realsolarcarsllc/solarcarengineering/README.md

# Solar Car Engineering Support Package

This is a combined repository for most RSC boards.

We are packaging everything together for easier downloads. 
Look for the green "code" menu above. 
Open it and select the "Download Zip" option.

# Engineering Info
- Contactors and Battery Connections (SCE 01)
- Charging EVs from Supercapacitors (they don't hold enough energy)

# Boards
- pcdb2105 - 36v to 400v dc-dc converter with MPPT, aux buck converter, contactor control, coil economizer, dual CAN, failsafe CAN bridge, real time clock
- bci2103 - 40 pin connector to wire interface, with holes for pass-through diodes

© 2022 Real Solar Cars, LLC  
PO Box 9372   
Albuquerque, NM 87119-9372  
USA
