realsolarcarsllc/solarcarengineering/boards/README.md

# pcdb2105
High voltage DC-DC slow charger
- Input 31-45 Vdc MPPT, intended for 72 cell solar array
- Main Output 300-405 Vdc, >300w , isolated
- Aux Output 13.8 Vdc 5A nominal, programmable 0-30 Vdc, step down
- 40 pin connector for 12v GPIO
- - 5 Contactor control outputs with -36v coil suppression. 
- - - 3 with 0-5 Vdc economizer
- - 2 12v 1a max general purpose outputs with pass-through diode
- - 3 12v 1a max general purpose outputs
- - 2 CAN bus interfaces, with optional failsafe pass-through
- - 7 12v analog input pins
- 4 pin fan connector
- - 2 12v 1a max general purpose outputs
- qwiic connector
- Optional DS1307 real time clock

# bci2103
40 pin IO breakout board
- 7 passthrough diodes for contactor and control signals
- pads for EEPROM (not used)
