realsolarcarsllc/solarcarengineering/engineering/supercapacitor-charging-test.ods

Event | Timestamp | Volts
connected | 00:28
contactors | 00:31
 | 00:35 | 14.2
honk | 00:40 | 14.06
 | 00:45 | 13.7
 | 00:50 | 13.44
 | 00:55 | 13.13
 | 01:00 | 12.82
 | 01:05 | 12.51
 | 01:10 | 12.17
 | 01:15 | 11.82
 | 01:20 | 11.49
depleted | 01:27 | 10.97 | 00:00:47
 | 01:30 | 11.1
 | 01:40 | 11.3
 | 01:50 | 11.49
 | 02:00 | 11.68
 | 02:10
 | 02:20 | 12.04
 | 02:30 | 12.23
 | 02:40 | 12.4
 | 02:50
 | 03:00
 | 03:10
 | 03:20 | 13.05
 | 03:30 | 13.19
 | 03:40 | 13.3
 | 03:50 | 13.4
 | 04:00 | 13.5
 | 04:10 | 13.59
 | 04:20 | 13.68
 | 04:30
 | 04:40 | 13.82
 | 04:50
 | 05:00 | 13.93
 | 05:10 | 13.98
connected | 05:15 | 14
contactors | 05:17 | 14.01
 | 05:20 | 14.02
honk | 05:28 | 13.9 | 00:04:01
 | 05:30 | 13.81
 | 05:35 | 13.5
 | 05:40 | 13.2
 | 05:45 | 12.88
 | 05:50 | 12.59
 | 05:55 | 12.24
 | 06:00 | 11.89
 | 06:05 | 11.5
 | 06:10 | 11.17
 | 06:15 | 10.77
end | 06:20 | 10.46 | 00:00:52
 | Seconds
Discharge 1 | 47
Recharge | 241 | 173 | if losses fixed
Discharge 2 | 52
Cycle Time | 293
Minutes/Cycle | 4
Cycles/Hour | 15
Hours/Day | 8
Cycles/Day | 120
Cycles/Year | 43800
 |  | Years
Mechanical | 200000 | 4.57
Full Load | 3000 | 0.07
Per Capacitor | $57.00
6s Pack | $342.00
Per Cell | $61.67
6s Pack | $370.00
Volts | 2.3
Ah | 35
Cells | 6
Wh | 483
80% Discharge | 386 | Wh
Volts | 120
Watts | 6.5
AC Power | 780
Inverter | 90.00%
DC Power | 867
 |  | Hours
PV Charge W | 300 | 1.29
Discharge W | 567 | 0.68
 |  | 1.97
Minutes/Cycle | 118.19
Cycles/Hour | 0.51
Hours/Day | 8.00
Cycles/Day | 4.06
Cycles/Year | 1482
 |  | Years
Mechanical | 200000 | 134.92
Full Load | 3000 | 2.02
Battery Cycles | 20000 | 13.49
Conclusions
Supercapacitors should not be used for solar charging EVS.
 | Does not store enough energy
 | EV contactors will wear out
Lithium Titanate batteries appear to be suitable for this purpose.
 | Acceptable 4 cycles/day on EV contactors
 | Expected to last 13 years
 | Cost similar to supercapacitors
