realsolarcarsllc/solarcarengineering/boards/bci2103/schematic.pdf

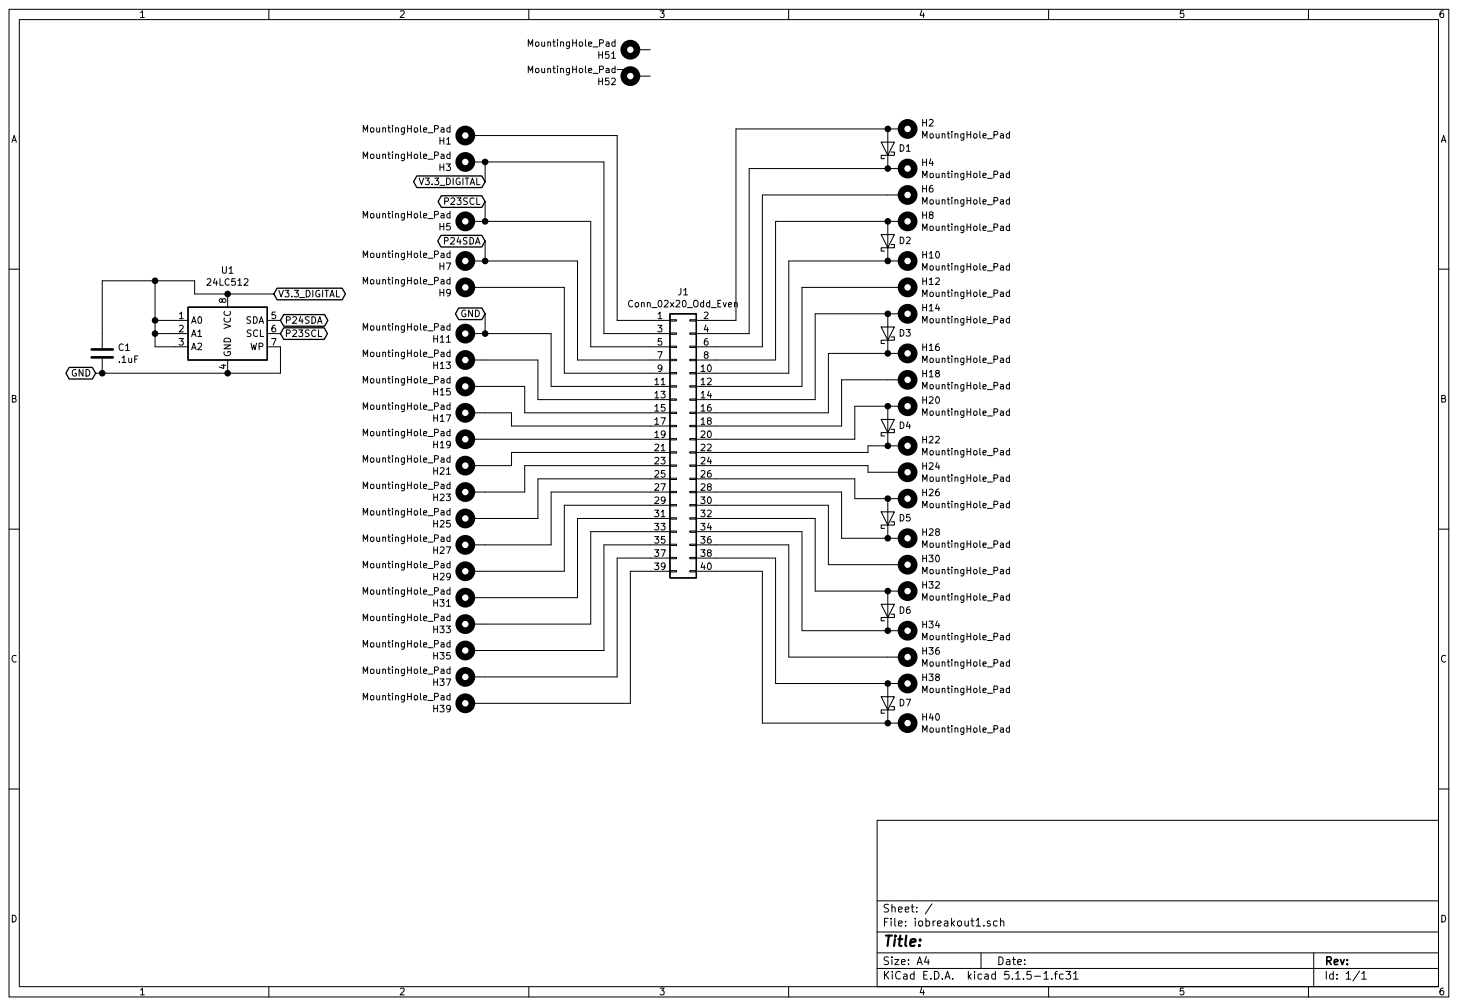
[picture p1: page 1]

31 | 32
33 | 34
35 | 36
37 | 38

Id: 1/1 Title: File: iobreakout1.sch Sheet: /
