realsolarcarsllc/solarcarengineering/boards/bci2103/iobreakout1.kicad_pcb

## KiCad design boards/bci2103/iobreakout1.kicad_pcb (2021-10-12)

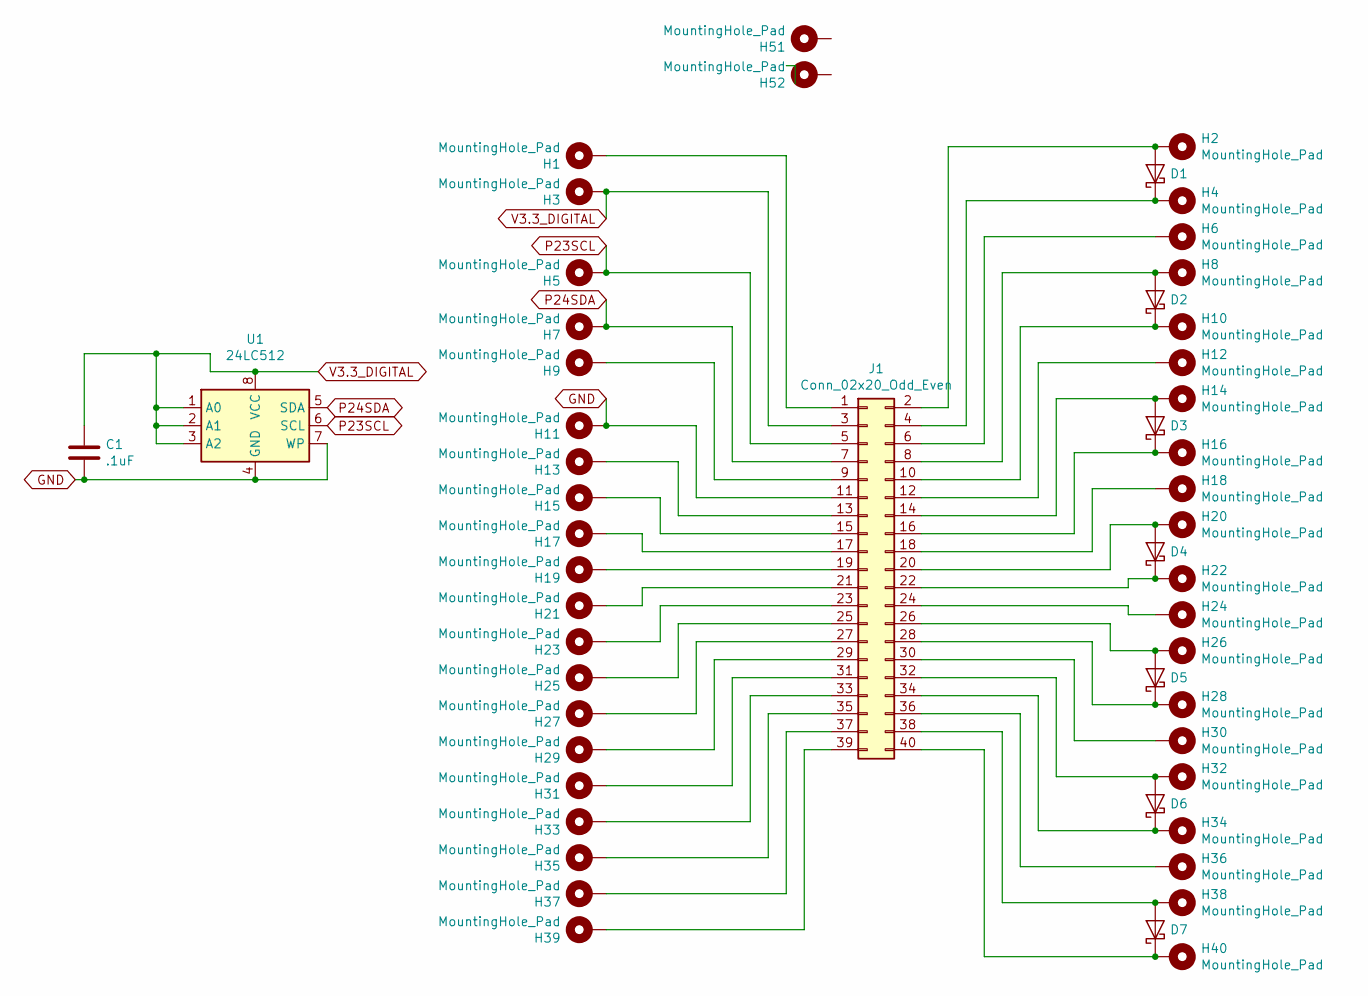
[picture p13: schematic iobreakout1.sch]

Parts:
C101: .1uF; C_0603_1608Metric_Pad1.05x0.95mm_HandSolder
D1, D2, D3, D4, D5, D6, D7: 1N5819; D_DO-41_SOD81_P2.54mm_Vertical_AnodeUp
H1, H2, H3, H4, H5, H6, H7, H8, H9, H10, H11, H12, H13, H14, H15, H16, H17, H18, H19, H20, H21, H22, H23, H24, H25, H26, H27, H28, H29, H30, H31, H32, H33, H34, H35, H36, H37, H38, H39, H40: MountingHole_Pad; TestPoint_THTPad_D2.5mm_Drill1.2mm
H51, H52: MountingHole_Pad; MountingHole_3mm_Pad_Via
J1: Conn_02x20_Odd_Even; PinSocket_2x20_P2.54mm_Vertical
U1: 24LC512; TSSOP-8_4.4x3mm_P0.65mm

Connections:
GND: H11.1, J1.11, U1.4 (GND), U1.7 (WP); also elsewhere on the board
unnamed: D1.1 (K), H4.1, J1.4
unnamed: D1.2 (A), H2.1, J1.2
unnamed: D2.1 (K), H10.1, J1.10
unnamed: D2.2 (A), H8.1, J1.8
unnamed: D3.1 (K), H16.1, J1.16
unnamed: D3.2 (A), H14.1, J1.14
unnamed: D4.1 (K), H22.1, J1.22
unnamed: D4.2 (A), H20.1, J1.20
unnamed: D5.1 (K), H28.1, J1.28
unnamed: D5.2 (A), H26.1, J1.26
unnamed: D6.1 (K), H34.1, J1.34
unnamed: D6.2 (A), H32.1, J1.32
unnamed: D7.1 (K), H40.1, J1.40
unnamed: D7.2 (A), H38.1, J1.38
unnamed: H1.1, J1.1
unnamed: H6.1, J1.6
unnamed: H9.1, J1.9
unnamed: H12.1, J1.12
unnamed: H13.1, J1.13
unnamed: H15.1, J1.15
unnamed: H17.1, J1.17
unnamed: H18.1, J1.18
unnamed: H19.1, J1.19
unnamed: H21.1, J1.21
unnamed: H23.1, J1.23
unnamed: H24.1, J1.24
unnamed: H25.1, J1.25
unnamed: H27.1, J1.27
unnamed: H29.1, J1.29
unnamed: H30.1, J1.30
unnamed: H31.1, J1.31
unnamed: H33.1, J1.33
unnamed: H35.1, J1.35
unnamed: H36.1, J1.36
unnamed: H37.1, J1.37
unnamed: H39.1, J1.39
P23SCL: H5.1, J1.5, U1.6 (SCL)
P24SDA: H7.1, J1.7, U1.5 (SDA)
V3.3_DIGITAL: H3.1, J1.3, U1.1 (A0), U1.2 (A1), U1.3 (A2), U1.8 (VCC); also elsewhere on the board

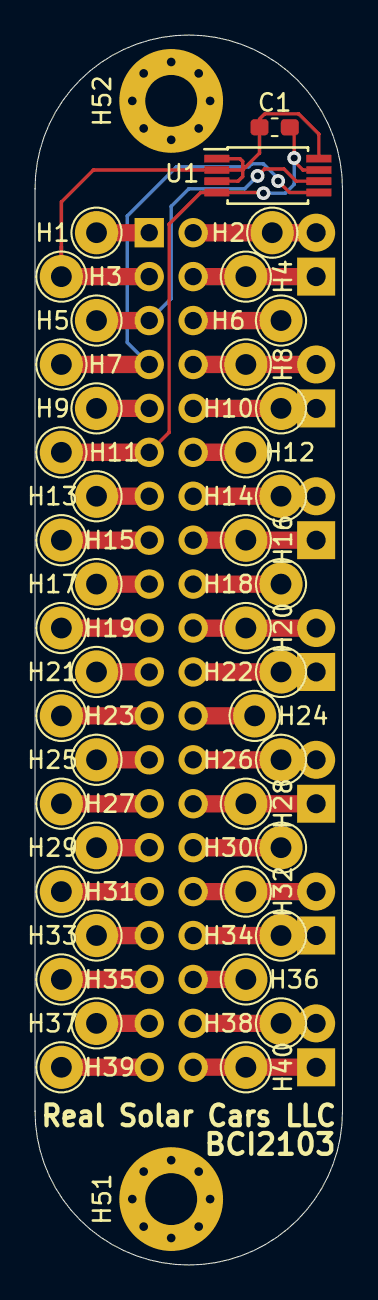
[picture p14: board iobreakout1.kicad_pcb from above]

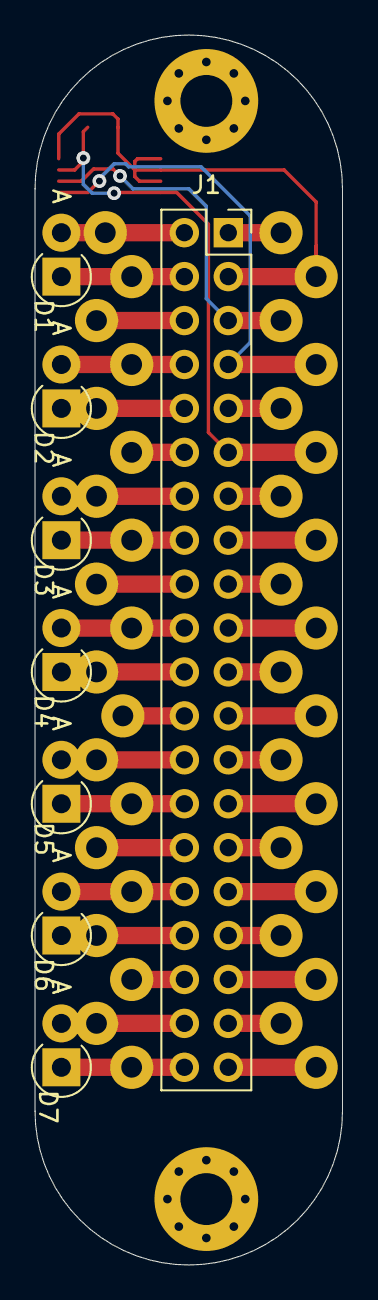
[picture p15: board iobreakout1.kicad_pcb from below]

Board: 2 copper layers, 17.8 x 71.1 mm, 52 parts (8 on the bottom side), 40 nets.

Other parts of the board:
C1: .1uF; C_0603_1608Metric_Pad1.05x0.95mm_HandSolder

Their connections:
GND: C1.2; also elsewhere on the board
V3.3_DIGITAL: C1.1; also elsewhere on the board
