realsolarcarsllc/solarcarengineering/(commit log)

2021-10-12 add bci2103
    [iobreakout1.kicad_pcb, iobreakout1.sch]
2021-10-12 separate dirs for pcb and software
2021-10-12 Add order form
    [order-form.ods]
2021-10-12 Some engineering worksheets for contactors and supercapacitors
    [sce01-battery-connection.kicad_pcb, sce01-battery-connection.sch, sce01-contactor-worksheet.ods, supercapacitor-charging-test.ods]
2021-10-12 breakout board schematic in PDF
    [iobreakout1.kicad_pcb]
2021-10-12 preview link for BOM
2021-10-12 Schematic preview link
2021-10-14 More accurate input voltage sensor using DAC for calibration
2022-04-27 policy compliance
    [iobreakout1.kicad_pcb, iobreakout1.sch, order-form.ods]
2022-05-02 We do not generally prohibit use of GitHub for advertising, but we won't tell you what files flagged your repository.
    [sce01-contactor-worksheet.ods]
2022-09-10 Basic relay control functions for DRV89xx
2022-09-10 ADC libary to support calibration using multiplexer
2022-09-11 Volt G1 minimum viable product
2022-10-23 Chevy Volt 2014 charge while parked basic
